copenhagen2/Ultrasonic_following_car/final_project_car/Src/main.c

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

/* Includes ------------------------------------------------------------------*/
#include "main.h"
#include "adc.h"
#include "tim.h"
#include "usart.h"
#include "gpio.h"

/* USER CODE BEGIN Includes */
#include <math.h>
#include <string.h>
/* USER CODE END Includes */

/* USER CODE BEGIN PTD */
typedef struct {
		float rec[10];
		float max_v;
		float min_v;
		float vpp;
		uint8_t count;
} VOL;

typedef struct {
		float kp, ki, kd;
		float pmax, imax, dmax;
		float sum;
		float this_error;
		float last_error;
		float output;
} PID;
/* USER CODE END PTD */

/* USER CODE BEGIN PD */
#define VCC 3.3
#define max(a,b) ((a>b)? a:b)
#define min(a,b) ((a>b)? b:a)
#define INRANGE(NUM, MIN, MAX) \
{\
    if(NUM<MIN){\
        NUM=MIN;\
    }else if(NUM>MAX){\
        NUM=MAX;\
    }\
}
/* USER CODE END PD */


/* USER CODE BEGIN PV */
float right = 0;
float left = 0;
float delta = 0;
float speed1 = 0;
float speed2 = 0;
uint8_t state = 0;
uint8_t cmd = 0;
VOL sonic_left = {
		.rec = {0},
		.max_v = 0,
		.min_v = VCC,
		.count = 0,
		.vpp = 0,
};

VOL sonic_right = {
		.rec = {0},
		.max_v = 0,
		.min_v = VCC,
		.count = 0,
		.vpp = 0,
};

PID pid = {
		.kp = 900,
		.ki = 0,
		.kd = 100,
		.pmax = 700,
		.imax = 0,
		.dmax = 600,
		.sum = 0,
		.this_error = 0,
};
/* USER CODE END PV */

void SystemClock_Config(void);
/* USER CODE BEGIN PFP */
void SetChassisSpeed(int16_t left, int16_t right);
void ReadSonicVoltage(VOL *feedback, float value);
float Calculate(PID *pid, float error); 
void MainControlLoop(void);
/* USER CODE END PFP */

/**
  * @brief  The application entry point.
  * @retval int
  */
int main(void)
{
  

  /* MCU Configuration--------------------------------------------------------*/

  /* Reset of all peripherals, Initializes the Flash interface and the Systick. */
  HAL_Init();

  /* Configure the system clock */
  SystemClock_Config();

  /* Initialize all configured peripherals */
  MX_GPIO_Init();
  MX_TIM1_Init();
  MX_ADC1_Init();
  MX_USART1_UART_Init();
  MX_ADC2_Init();
  MX_TIM3_Init();
  /* USER CODE BEGIN 2 */
	HAL_UART_Transmit_IT(&huart1, (uint8_t *)&("Power On\n"), sizeof("Power On\n"));
	HAL_TIM_Base_Start(&htim3);
	HAL_TIM_PWM_Start(&htim3, TIM_CHANNEL_1);
	HAL_TIM_PWM_Start(&htim3, TIM_CHANNEL_2);
	HAL_TIM_PWM_Start(&htim3, TIM_CHANNEL_3);
	HAL_TIM_PWM_Start(&htim3, TIM_CHANNEL_4);
	HAL_ADCEx_Calibration_Start(&hadc1);
	HAL_ADCEx_Calibration_Start(&hadc2);
	HAL_TIM_Base_Start_IT(&htim1);
	//HAL_TIM_Base_Start_IT(&htim2);
	HAL_ADC_Start_IT(&hadc1);
	HAL_ADC_Start_IT(&hadc2);
  /* USER CODE END 2 */

  /* Infinite loop */
  /* USER CODE BEGIN WHILE */
  while (1)
  {
    /* USER CODE END WHILE */

    /* USER CODE BEGIN 3 */
		HAL_UART_Receive_IT(&huart1, (uint8_t *)&cmd, sizeof(cmd));
		//MainControlLoop();
		// SetChassisSpeed(0, 0); 
		if (cmd == 'n' || cmd == 'N') {
			SetChassisSpeed(0,0);
		}
		else if (cmd == 'y' || cmd == 'Y') {
			MainControlLoop();
		}
		else if (cmd == 't' || cmd == 'T') {
			delta = sonic_left.vpp - sonic_right.vpp;
			float out = Calculate(&pid, delta);
			SetChassisSpeed(-out, out);
		}
		//MainControlLoop();
  }
  /* USER CODE END 3 */
}

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
/* USER CODE BEGIN 4 */

/**
*** The IT callback functions
*/
void HAL_UART_RxCpltCallback(UART_HandleTypeDef *huart) {
		if (huart->Instance == huart1.Instance) {
				HAL_UART_Transmit_IT(&huart1, (uint8_t *)&("OK"), sizeof("OK"));
		}
}

void HAL_TIM_PeriodElapsedCallback(TIM_HandleTypeDef *htim) {
		if (htim->Instance == htim1.Instance) { //400kHz used to measure the voltage of sonic sensor
				ReadSonicVoltage(&sonic_left, left);
				ReadSonicVoltage(&sonic_right, right);
			//MainControlLoop();
		}
}

void HAL_ADC_ConvCpltCallback(ADC_HandleTypeDef* hadc) {
		if (hadc->Instance == hadc1.Instance) {
				left = (float)HAL_ADC_GetValue(&hadc1) / 4096.0f * VCC; //12-digits adc
				HAL_ADC_Start_IT(&hadc1);
		}
		if (hadc->Instance == hadc2.Instance) {
				right = (float)HAL_ADC_GetValue(&hadc2) / 4096.0f * VCC; //12-digits adc
				HAL_ADC_Start_IT(&hadc2);
		}
}
/** 
*** Functions for chassis-controlling
*/
void SetChassisSpeed(int16_t left, int16_t right) {
		// left motor
		if (left > 0) {
				__HAL_TIM_SetCompare(&htim3, TIM_CHANNEL_1, left);
			  __HAL_TIM_SetCompare(&htim3, TIM_CHANNEL_2, 0);
		}
		else if (left == 0) {
				__HAL_TIM_SetCompare(&htim3, TIM_CHANNEL_1, 0);
			  __HAL_TIM_SetCompare(&htim3, TIM_CHANNEL_2, 0);
		}
		else if (left < 0) {
				__HAL_TIM_SetCompare(&htim3, TIM_CHANNEL_1, 0);
			  __HAL_TIM_SetCompare(&htim3, TIM_CHANNEL_2, -left);
		}
		
		// right motor
		if (right > 0) {
				__HAL_TIM_SetCompare(&htim3, TIM_CHANNEL_3, right);
			  __HAL_TIM_SetCompare(&htim3, TIM_CHANNEL_4, 0);
		}
		else if (right == 0) {
				__HAL_TIM_SetCompare(&htim3, TIM_CHANNEL_3, 0);
			  __HAL_TIM_SetCompare(&htim3, TIM_CHANNEL_4, 0);
		}
		else if (right < 0) {
				__HAL_TIM_SetCompare(&htim3, TIM_CHANNEL_3, 0);
			  __HAL_TIM_SetCompare(&htim3, TIM_CHANNEL_4, -right);
		}
}
/**
*** Read sonic value
*/
void ReadSonicVoltage(VOL *feedback, float value) {
		feedback->rec[feedback->count] = value;
		feedback->count++;
		if (feedback->count == 10) {
				for (int i = 0; i < 10; i++) {
						feedback->max_v = max(feedback->max_v, feedback->rec[i]);
						feedback->min_v = min(feedback->min_v, feedback->rec[i]);
				}
				feedback->vpp = feedback->max_v - feedback->min_v;
				feedback->count = 0;
				feedback->max_v = 0;
				feedback->min_v = VCC;
		}
}
/**
*** pid regulater
*/
float Calculate(PID *pid, float error) {
		pid->last_error = pid->this_error;
		pid->this_error = error;
		float pcom = pid->kp * pid->this_error;
		float dcom = pid->kd * (pid->this_error - pid->last_error);
		pid->sum += pid->this_error;
		INRANGE(pcom, -pid->pmax, pid->pmax)
		INRANGE(dcom, -pid->dmax, pid->dmax)
		INRANGE(pid->sum, -pid->imax, pid->imax)
		pid->output = pcom + dcom + pid->sum * pid->ki;
		return pid->output;
}
/**
*** main control loop
*/
void MainControlLoop() {
		//stop
		if (sonic_left.vpp > 1.2f || sonic_right.vpp > 1.20f) {
				SetChassisSpeed(0,0);
				state = 0;
				return;
		}
		//forward
		if (fabs(sonic_left.vpp - sonic_right.vpp) < 0.4) {
				SetChassisSpeed(550,550);
				state = 1;
				return;
		}
		//turn
		else {
			delta = sonic_left.vpp - sonic_right.vpp;
			float out = Calculate(&pid, delta);
			SetChassisSpeed(-out, out);
		}			
}
/* USER CODE END 4 */
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
