copenhagen2/Ultrasonic_following_car/final_project_car/final_project.ioc

Mcu.UserName=STM32F103C6Tx
PA1.GPIO_Label=SONIC_LEFT
PA1.Signal=SharedAnalog_PA1
PA10.Signal=USART1_RX
PA13.Signal=SYS_JTMS-SWDIO
PA14.Signal=SYS_JTCK-SWCLK
PA2.GPIO_Label=SONIC_RIGHT
PA2.Signal=SharedAnalog_PA2
PA6.Signal=S_TIM3_CH1
PA7.Signal=S_TIM3_CH2
PA9.Signal=USART1_TX
PB0.Signal=S_TIM3_CH3
PB1.Signal=S_TIM3_CH4
PC13-TAMPER-RTC.GPIO_Label=LED_Pin
PC13-TAMPER-RTC.Signal=GPIO_Output
PD0-OSC_IN.Signal=RCC_OSC_IN
PD1-OSC_OUT.Signal=RCC_OSC_OUT
