copenhagen2/Ultrasonic_following_car/final_project_car/Inc/main.h

#define LED_Pin_Pin GPIO_PIN_13
#define LED_Pin_GPIO_Port GPIOC
#define SONIC_LEFT_Pin GPIO_PIN_1
#define SONIC_LEFT_GPIO_Port GPIOA
#define SONIC_RIGHT_Pin GPIO_PIN_2
#define SONIC_RIGHT_GPIO_Port GPIOA
